mwpm/UltrasonicWayFinder/README.md

# UltrasonicWayFinder
An embedded system designed to aid the visually impaired individual by using ultrasonic sensors, two PIC18F25k22 MCUs, and haptic feedback. The feedback would increase in intensity the closer an object gets to the ultrasonic sensors. A Bluetooth module was used to send data to an observer.

More information in UltrasonicWayFinder.docx
