mwpm/UltrasonicWayFinder/Documents/HW block diagram.png

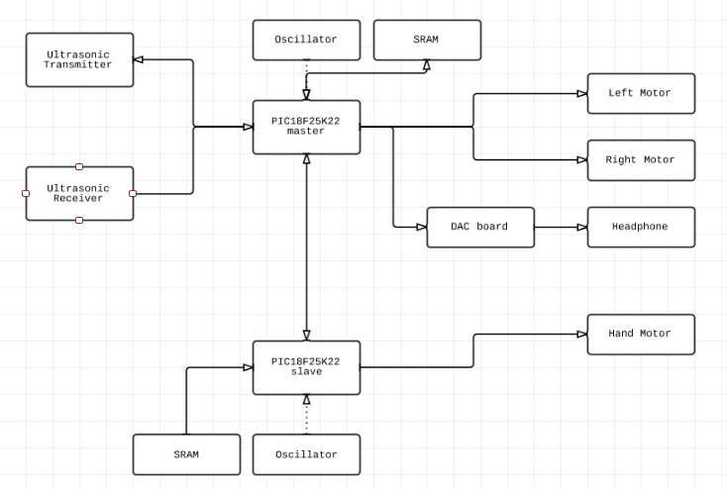
Documents/HW block diagram.png
