mwpm/UltrasonicWayFinder/screenshots/12f50l7r.png

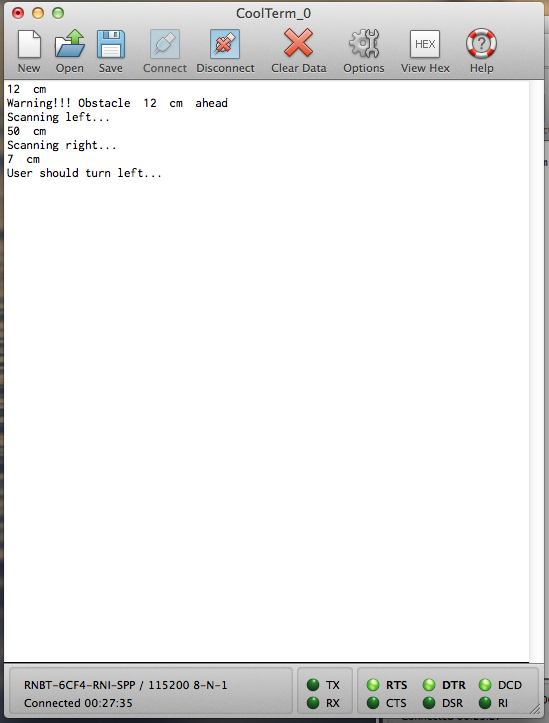
screenshots/12f50l7r.png
