mwpm/UltrasonicWayFinder/screenshots/help sent.png

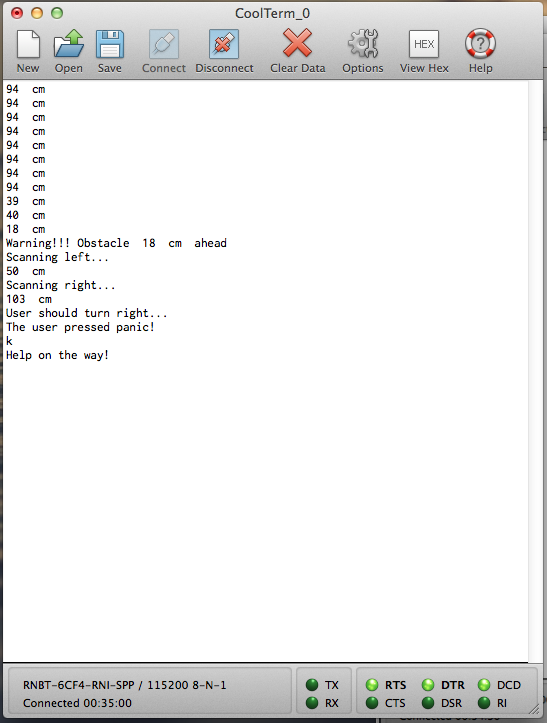
screenshots/help sent.png
