mwpm/UltrasonicWayFinder/screenshots/panic.png

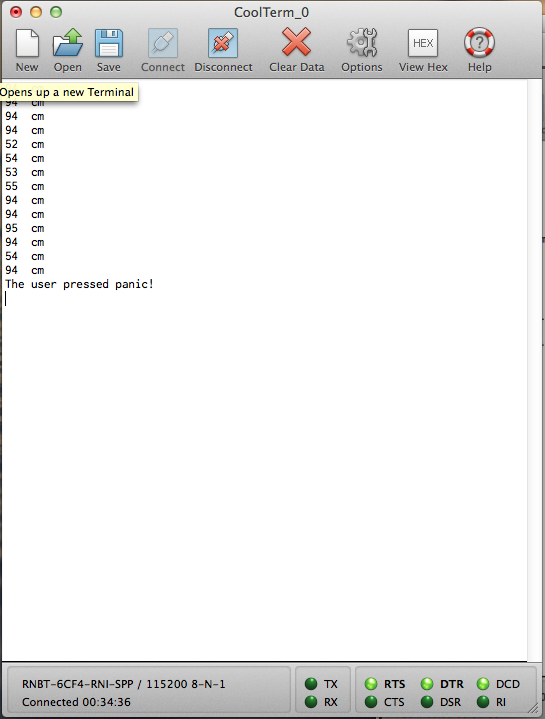
screenshots/panic.png
